SaintGimp/MotorController/README.md

# MotorController

The board files use the libraries and design rules from https://github.com/SaintGimp/Eagle.
