SaintGimp/MotorController/board/BOM.xlsx

Sheet: BOM
Qty | Value | Device | Package | Parts | Manufacturer Part Number | Description | Notes
1 | 1000uF | CAP-POL-25-14 | CAP-POL-25-14 | C11 | EEU-FR1H102 | Polarized Capacitor | Expensive but long-life, 470uF version is EEU-FR1H471B
2 | 10uF | CAPACITOR-5MM | CAPACITOR-5MM | C8, C9 | FK20X7S1H106K | Ceramic Capacitor | Ammo pack
3 | 1uF | CAPACITOR-2.5MM | CAPACITOR-2.5MM | C6, C7, C10 | FK14X7R1H105K | Ceramic Capacitor | Bulk (maybe)
3 | 0.1uF | CAPACITOR-2.5MM | CAPACITOR-2.5MM | C1, C2, C5 | K104K15X7RF53L2 | Ceramic Capacitor | Bulk
2 | 20pF | CAPACITOR-2.5MM | CAPACITOR-2.5MM | C3, C4 | SR151A200JAR | Ceramic Capacitor | Bulk
1 | 576K | RESISTOR-7.5MM | AXIAL-7.5MM | R7 | MFR-25FBF52-576K |  | Bulk
2 | 10K | RESISTOR-7.5MM | AXIAL-7.5MM | R2, R8 | MFR-25FBF52-10K |  | Bulk
2 | 1K | RESISTOR-7.5MM | AXIAL-7.5MM | R5, R6 | MFR-25FBF52-1K |  | Bulk
2 | 220 | RESISTOR-7.5MM | AXIAL-7.5MM | R3, R4 | MF1/4DC2200F |  | Bulk
1 | 68 | RESISTOR-7.5MM | AXIAL-7.5MM | R1 | MF1/4DC68R0F |  | Bulk
1 | 27V | ZENER-7.5 | ZDIO-7.5 | D2 | 1N5254B-TAP | Zener Diode | Ammo pack
1 | 22V | ZENER-7.5 | ZDIO-7.5 | D1 | 1N5251B-TAP | Zener Diode | Ammo pack
2 | 10V | ZENER-7.5 | ZDIO-7.5 | D3, D4 | 1N5240B-TAP | Zener Diode | Ammo pack
1 | BT139X-600E | TRIAC-H | TO220BH | Q1 | BT137-600E,127 | TRIAC
2 | SUP53P06-20-E3 | SUP53P06-20-E3 | TO220BH | Q2, Q3 | SUP53P06-20-E3 | P-Channel MOSFET
1 | OKI-78SR-5/1.5-W36H-C | DC-CONV | DC-CONV | DC1 | OKI-78SR-5/1.5-W36H-C | DC-DC Converter
1 | ATMEGA328P-PU | ATMEGA328P-PU | DIP28 | IC1 | ATMEGA328P-PU | 8-bit Microcontroller with In-System Programmable Flash
1 | 28P | Socket | DIP28 | IC1 | 1-2199298-9 |  | Optional
1 | 16Mhz | CRYSTAL-V | CRYSTAL-V | Y1 | ATS16A | Crystal Oscillator
1 | 4A-MEDIUM-BLOW | FUSE | FUSE_5X20MM | F1 | 5MT 4-R |  | Derated 25% per standard, consider fast-blow?
2 | 4A | FUSE CLIP | FUSE_CLIP_5MM | F1 | 01000056Z
4 | SWITCH-MOMENTARY-6MM | SWITCH-MOMENTARY-6MM | TACTILE-SWITCH-6MM | S1, S2, S3, S4 | B3F-1020
 | version 3.1.1

Sheet: Inventory
Qty | Description | Manufacturer Part Number | Substitutes | Totals | Unit Inventory | 2015-07-30 | 10 | 2015-10-27 | 20 | 2016-04-04 | 25 | 2016-09-12 | 25 | 2017-09-14 | 50 | Adjust | 2019-04-23 | 57 | 2021-09-21
2 | P-MOSFET | SUP53P06-20-E3 |  | 127 | 63.5 | 0 |  | 40 | -40 | 50 | -50 | 50 | -50 | 105 | -100 | 6 | 110 | -114 | 120
1 | 576K resistor | MFR-25FBF52-576K |  | 63 | 63 | 200 | -10 | * | -20 | * | -25 | * | -25 | * | -50 |  | * | -57 | 50
2 | 10V zener | 1N5240B-TAP |  | 139 | 69.5 | 100 | -20 | * | -40 | 100 | -50 | * | -50 | 100 | -100 | -7 | 100 | -114 | 120
1 | 1000uF capacitor | EEU-FR1H102 | 50YXJ1000M16X25 | 60 | 60 | 10 | -10 | 20 | -20 | 50 | -25 | * | -25 | 55 | -50 | 2 | 50 | -57 | 60
2 | 220R resistor | MF1/4DC2200F |  | 130 | 65 | 100 | -20 | * | -40 | 100 | -50 | * | -50 | 100 | -100 | -16 | 100 | -114 | 120
1 | 68R resistor | MF1/4DC68R0F |  | 113 | 113 | 100 | -10 | * | -20 | * | -25 | * | -25 | 100 | -50 |  | * | -57 | 100
1 | DIP socket | 1-2199298-9 |  | 64 | 64 | 10 | -10 | 20 | -20 | 25 | -25 | 25 | -25 | 55 | -50 | 1 | 55 | -57 | 60
1 | MCU | ATMEGA328P-PU |  | 68 | 68 | 10 | -10 | 20 | -20 | 25 | -25 | 25 | -25 | 55 | -50 | -5 | 65 | -57 | 60
1 | Crystal | ATS16A |  | 63 | 63 | 10 | -10 | 20 | -20 | 25 | -25 | 25 | -25 | 55 | -50 |  | 55 | -57 | 60
3 | 1uF capacitor | FK14X7R1H105K |  | 191 | 63.66666667 | 100 | -30 | * | -60 | 100 | -75 | 100 | -75 | 120 | -150 | 12 | 140 | -171 | 180
3 | 0.1uF capacitor | K104K15X7RF53L2 |  | 185 | 61.66666667 | 100 | -30 | * | -60 | 100 | -75 | 100 | -75 | 100 | -150 | 16 | 150 | -171 | 180
2 | 20pF capacitor | SR151A200JAR | SL151A200JAB | 134 | 67 | 100 | -20 | * | -40 | 100 | -50 | * | -50 | 100 | -100 | 8 | 100 | -114 | 100
2 | Fuse clip | 01000056Z |  | 120 | 60 | 20 | -20 | 40 | -40 | 50 | -50 | 50 | -50 | 105 | -100 | 9 | 100 | -114 | 120
1 | 4A fuse | 0234004.MXP |  | 67 | 67 | 10 | -10 | 20 | -20 | 25 | -25 | 25 | -25 | 55 | -50 | 4 | 50 | -57 | 65
1 | DC converter | OKI-78SR-5/1.5-W36H-C | 7805SRH-C | 60 | 60 | 10 | -10 | 20 | -20 | 25 | -25 | 25 | -25 | 55 | -50 | 2 | 50 | -57 | 60
2 | 1K resistor | MFR-25FBF52-1K |  | 130 | 65 | 200 | -20 | * | -40 | * | -50 | * | -50 | 70 | -100 | 14 | 100 | -114 | 120
2 | 10K resistor | MFR-25FBF52-10K | MF0207FTE52-10K | 136 | 68 | 200 | -20 | * | -40 | * | -50 | * | -50 | 70 | -100 |  | 120 | -114 | 120
1 | Triac | BT137-600E,127 |  | 100 | 100 | 10 | -10 | 20 | -20 | 25 | -25 | 25 | -25 | 55 | -50 | 2 | 50 | -57 | 100
1 | 22V zener | 1N5251B-TAP |  | 153 | 153 | 100 | -10 | * | -20 | * | -25 | * | -25 | 40 | -50 |  | 100 | -57 | 100
1 | 27V zener | 1N5254B-TAP |  | 143 | 143 | 100 | -10 | * | -20 | * | -25 | * | -25 | 40 | -50 | -10 | 100 | -57 | 100
2 | 10uF capacitor | FK20X7S1H106K |  | 126 | 63 | 100 | -20 | * | -40 | 100 | -50 | * | -50 | 100 | -100 |  | 100 | -114 | 100
1 | PCB | PCB 3.1.1 |  | 76 | 76 |  | -10 |  | -20 |  | -25 |  | -25 |  | -50 | 188 |  | -57 | 75
 |  |  |  |  | 60
