SaintGimp/MotorController/board/MotorController.brd

## EAGLE design board/MotorController.brd (2019-05-02)

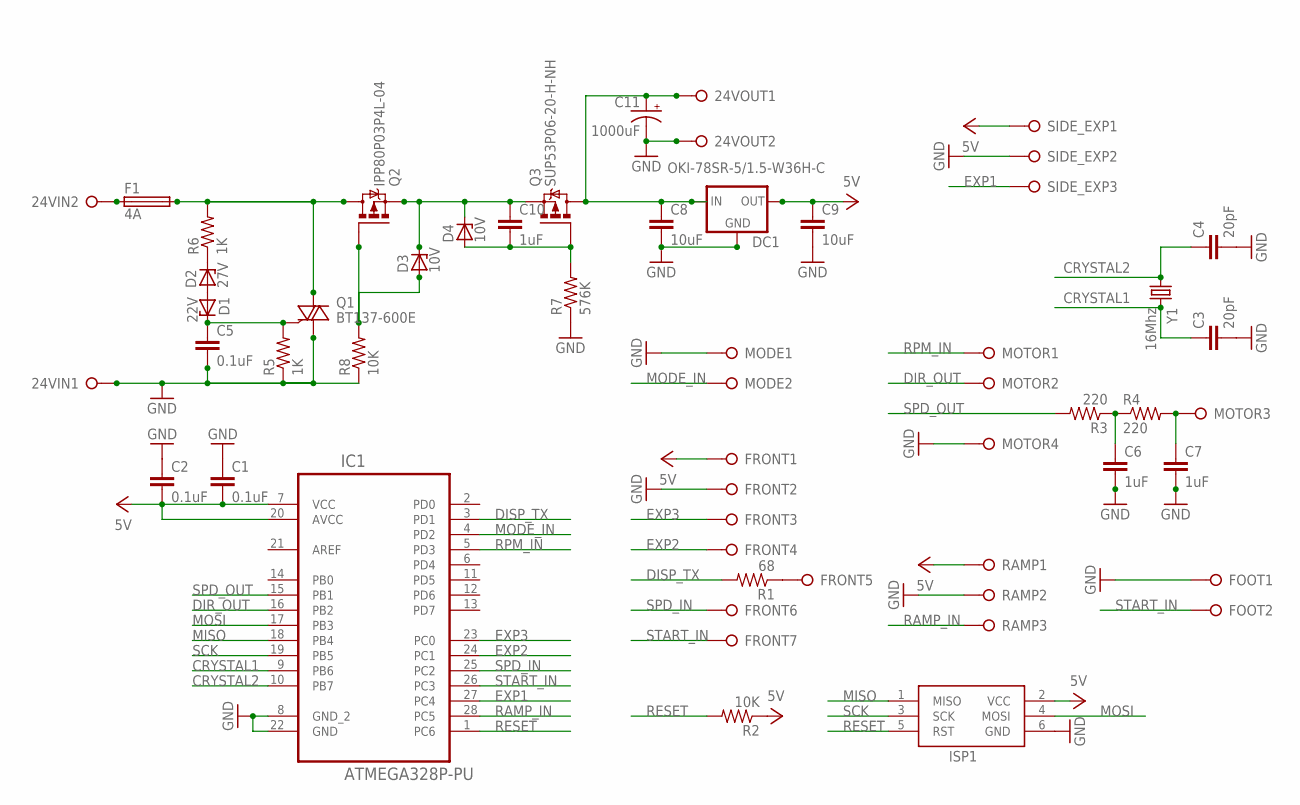
[picture p1: schematic MotorController.sch]

Parts:
24VIN, 24VOUT: PINHD-1X2BIG; 1X02-BIG
C1, C2, C5: 0.1uF; CAPACITOR-2.5MM
C3, C4: 20pF; CAPACITOR-2.5MM
C6, C7, C10: 1uF; CAPACITOR-2.5MM
C8, C9: 10uF; CAPACITOR-5MM
C11: 1000uF; CAP-POL-25-14
D1: 22V; ZDIO-7.5
D2: 27V; ZDIO-7.5
D3, D4: 10V; ZDIO-7.5
DC1: OKI-78SR-5/1.5-W36H-C; DC-CONV
F1: 4A; FUSE_HOLDER_5X20MM
FOOT: PINHD-1X2BIG; 1X02-BIG
FRONT: PINHD-1X7BIG; 1X07-BIG
IC1: ATMEGA328P-PU; DIP28
ISP1: ICSP-HEADER-6; ICSP-HEADER
MODE: PINHD-1X2BIG; 1X02-BIG
MOTOR: PINHD-1X4BIG; 1X04-BIG
Q1: BT137-600E; TO220BH-NO-HOLE
Q2: IPP80P03P4L-04; TO220BH-NO-HOLE
Q3: SUP53P06-20-H-NH; TO220BH-NO-HOLE
R1: 68; AXIAL-7.5MM
R2, R8: 10K; AXIAL-7.5MM
R3, R4: 220; AXIAL-7.5MM
R5, R6: 1K; AXIAL-7.5MM
R7: 576K; AXIAL-7.5MM
RAMP: PINHD-1X3BIG; 1X03-BIG
SIDE_EXP: PINHD-1X3BIG; 1X03-BIG
Y1: 16Mhz; CRYSTAL-V

Connections:
24V: F1.2, Q1.P2 (A2), Q2.P2 (D), R6.P$2 (2)
24V-PROTECTED: 24VOUT.1, C8.1, C11.+, DC1.P1 (IN), Q3.P2 (D)
CRYSTAL1: C3.1, IC1.9 (PB6), Y1.2
CRYSTAL2: C4.1, IC1.10 (PB7), Y1.1
DIR_OUT: IC1.16 (PB2), MOTOR.2
DISP_TX: IC1.3 (PD1), R1.P$2 (2)
EXP1: IC1.27 (PC4), SIDE_EXP.3
EXP2: FRONT.4, IC1.24 (PC1)
EXP3: FRONT.3, IC1.23 (PC0)
GND: 24VIN.1, 24VOUT.2, C1.1, C2.1, C3.2, C4.2, C5.2, C6.2, C7.2, C8.2, C9.2, C11.-, DC1.P2 (GND), FOOT.1, FRONT.2, IC1.8 (GND_2), IC1.22 (GND), ISP1.6 (GND), MODE.1, MOTOR.4, Q1.P1 (A1), R5.P$1 (1), R7.P$1 (1), R8.P$1 (1), RAMP.2, SIDE_EXP.2
MISO: IC1.18 (PB4), ISP1.1 (MISO)
MODE_IN: IC1.4 (PD2), MODE.2
MOSI: IC1.17 (PB3), ISP1.4 (MOSI)
unnamed: C6.1, R3.P$1 (1), R4.P$1 (1)
unnamed: 24VIN.2, F1.1
unnamed: D3.A, Q2.P1 (G), R8.P$2 (2)
unnamed: D2.C, R6.P$1 (1)
unnamed: D1.A, D2.A
unnamed: C5.1, D1.C, Q1.P3 (G), R5.P$2 (2)
unnamed: FRONT.5, R1.P$1 (1)
unnamed: C10.1, D3.C, D4.C, Q2.P3 (S), Q3.P3 (S)
unnamed: C7.1, MOTOR.3, R4.P$2 (2)
unnamed: C10.2, D4.A, Q3.P1 (G), R7.P$2 (2)
RAMP_IN: IC1.28 (PC5), RAMP.3
RESET: IC1.1 (PC6), ISP1.5 (RST), R2.P$2 (2)
RPM_IN: IC1.5 (PD3), MOTOR.1
SCK: IC1.19 (PB5), ISP1.3 (SCK)
SPD_IN: FRONT.6, IC1.25 (PC2)
SPD_OUT: IC1.15 (PB1), R3.P$2 (2)
START_IN: FOOT.2, FRONT.7, IC1.26 (PC3)
VCC: C1.2, C2.2, C9.1, DC1.P3 (OUT), FRONT.1, IC1.7 (VCC), IC1.20 (AVCC), ISP1.2 (VCC), R2.P$1 (1), RAMP.1, SIDE_EXP.1

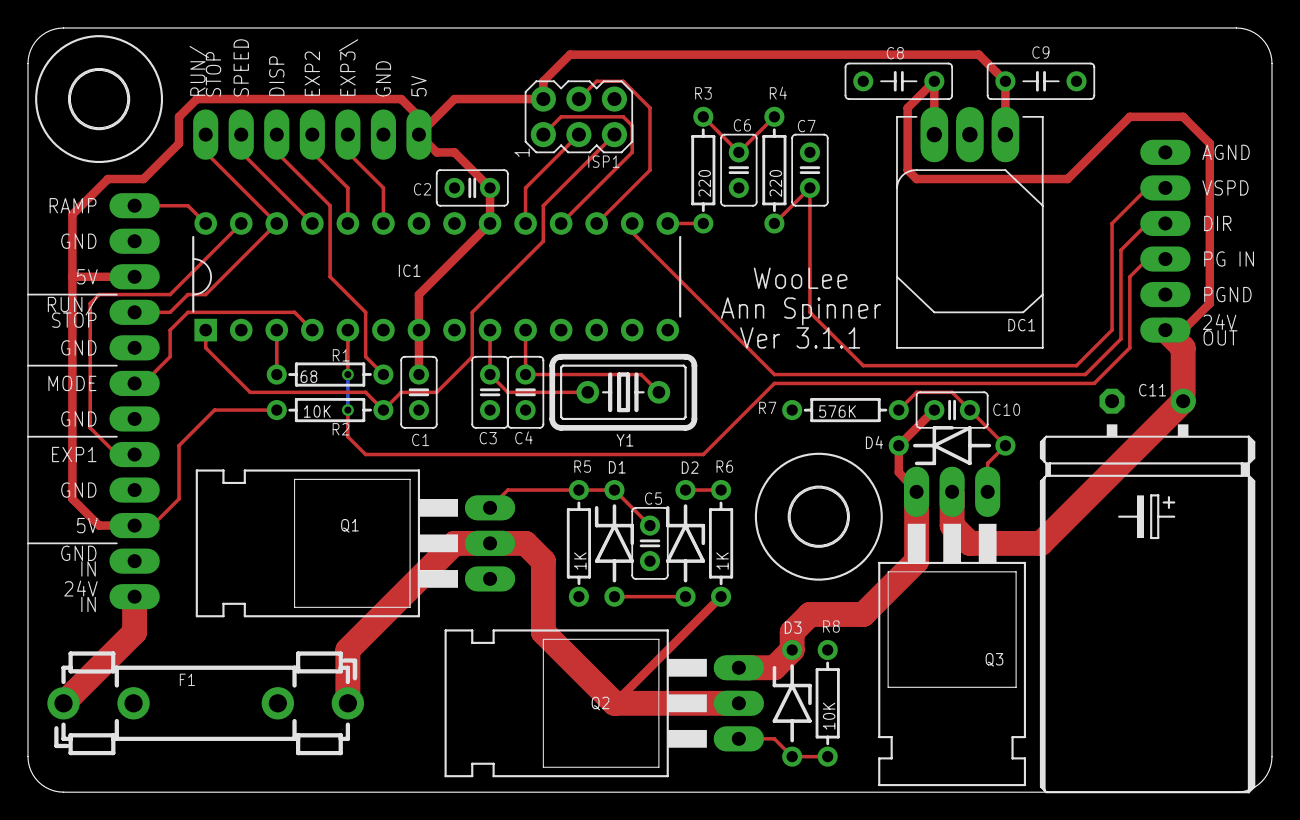
[picture p2: board MotorController.brd from above]

Board: 2 copper layers, 88.9 x 54.6 mm, 41 parts (0 on the bottom side), 31 nets.

Other parts of the board:
U$2, U$4: 4,1
