SaintGimp/MotorController/board/FrontPanel.brd

## EAGLE design board/FrontPanel.brd (2016-07-06)

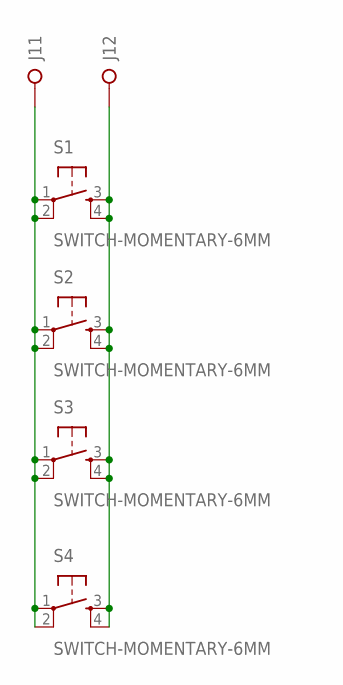
[picture p3: schematic FrontPanel.sch]

Parts:
J1: PINHD-1X2BIG; 1X02-BIG
S1, S2, S3, S4: SWITCH-MOMENTARY-6MM; TACTILE-SWITCH-6MM

Connections:
unnamed: J1.1, S1.1, S1.2, S2.1, S2.2, S3.1, S3.2, S4.1, S4.2
unnamed: J1.2, S1.3, S1.4, S2.3, S2.4, S3.3, S3.4, S4.3, S4.4

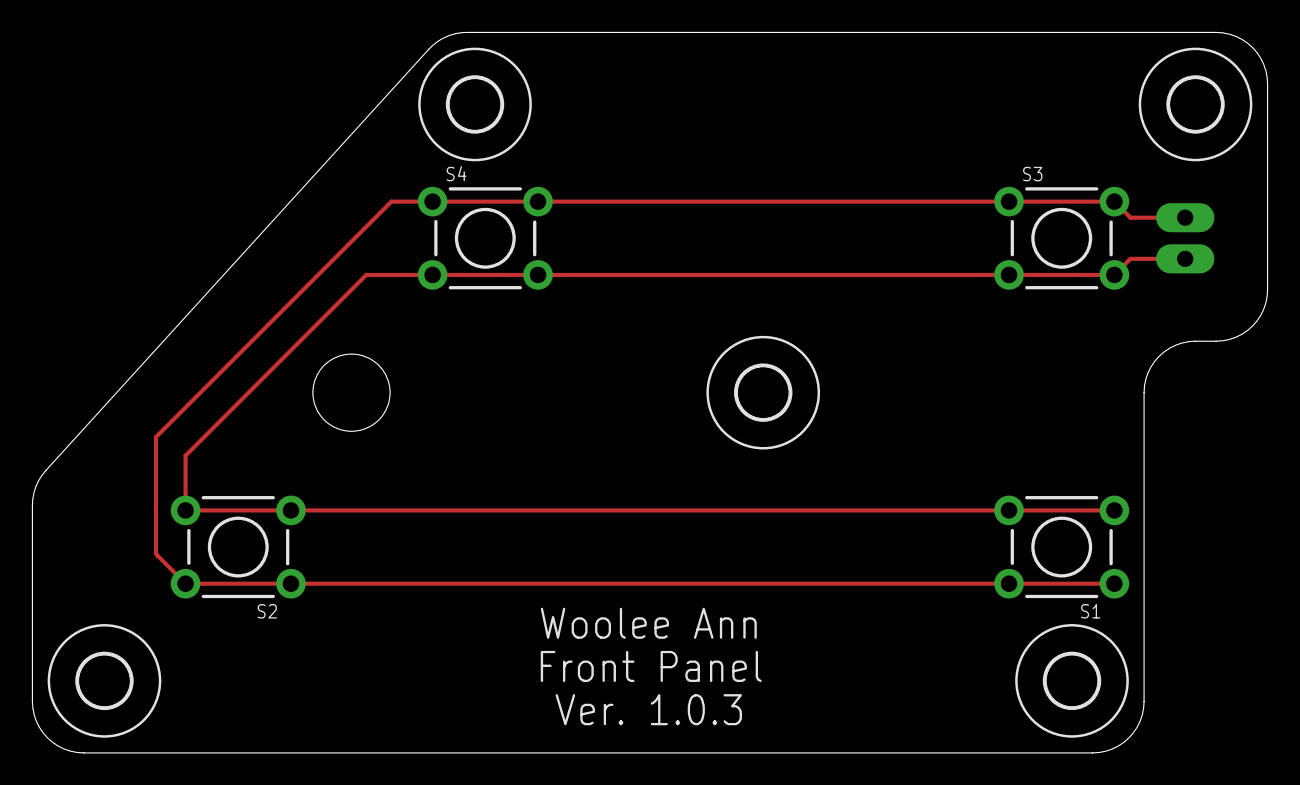
[picture p4: board FrontPanel.brd from above]

Board: 2 copper layers, 76.2 x 44.5 mm, 10 parts (0 on the bottom side), 2 nets.

Other parts of the board:
U$1, U$2, U$3, U$4, U$5: 3,2
