SaintGimp/MotorController/(commit log)

2013-12-05 Added rate pot, on/off and direction switches
2013-12-07 Arduino-tiny core for ATTiny MCUs
2013-12-07 Assume that ATTiny85 is going to need RESET disabled
    [ArduinoPrototype.ino]
2013-12-10 Fixed PWM output and renamed sketch
    [MotorController.ino]
2013-12-14 Include Eagle design files and move stuff around
    [MotorController.brd, MotorController.sch]
2013-12-14 Add a ground pour on the bottom plane and route all power and signal traces on the top
    [MotorController.brd, MotorController.sch]
2013-12-14 Tweaked schematic
    [MotorController.brd, MotorController.sch]
2013-12-14 Switch to a top GND pour
    [MotorController.brd, MotorController.sch]
2013-12-14 Switch to a horizontal regulator and change board layout to fit
    [MotorController.brd, MotorController.sch]
2013-12-28 Board tweaks, prototype labels
    [MotorController.brd]
2013-12-28 Only allow power on if current speed is 0
2014-01-02 Parameter tweaks based on prototype trials
2014-04-13 V2 prototype
    [PowerPrototype.brd, PowerPrototype.sch, ProcessorPrototype.brd, ProcessorPrototype.sch]
2014-04-17 Initial pass at a PCB and added clock code
    [MotorController.brd, MotorController.sch, PowerPrototype.brd, PowerPrototype.sch]
2014-04-28 PCB improvements
    [MotorController.brd, MotorController.sch]
2015-04-08 Update with current design rules and current library
    [MotorController.brd, MotorController.sch]
2015-04-08 Pull up reset line
    [MotorController.brd, MotorController.sch]
2015-04-09 Replace I2C with serial library
    [MotorController.ino]
2015-05-26 New board layout
    [MotorController.brd, MotorController.sch]
2015-05-26 Restore resistor values
    [MotorController.brd, MotorController.sch]
2015-05-26 Add dimensions
    [MotorController.brd]
2015-05-28 Board tweaks
    [MotorController.brd, MotorController.sch]
2015-05-28 Board layout improvements
    [MotorController.brd, MotorController.sch]
2015-05-28 Fix position of D3 label
    [MotorController.brd]
2015-05-29 Remove old prototype files
    [PowerPrototype.brd, PowerPrototype.sch, ProcessorPrototype.brd, ProcessorPrototype.sch]
2015-06-06 Change triac value
    [BOM.xlsx, MotorController.brd, MotorController.sch]
2015-06-06 Updated BOM
    [BOM.xlsx]
2015-07-10 Fix power input labels and increase isolation for ground plane
    [MotorController.brd]
2015-07-10 More BOM updates
    [BOM.xlsx]
2015-07-13 Start front panel board
    [FrontPanel.sch]
2015-07-13 Switch to pin headers and ATMega328P
    [MotorController.brd, MotorController.sch]
2015-07-18 Version 3, many changes
    [BOM.xlsx, MotorController.brd, MotorController.sch]
2015-07-18 Add soft-start capability to avoid high inrush current
    [BOM.xlsx, MotorController.brd, MotorController.sch]
2015-07-25 Front panel design with dimension markings
    [FrontPanel.brd, FrontPanel.sch]
2015-07-25 Many changes for version 3
    [BOM.xlsx, MotorController.brd, MotorController.sch]
2015-07-25 Clean up front panel
    [FrontPanel.brd]
2015-07-25 Front panel tweaks
    [FrontPanel.brd]
2015-07-27 Miter corners of control board
    [MotorController.brd]
2015-07-27 Adjust front panel layout
    [FrontPanel.brd]
2015-07-27 Spread out front panel buttons, flip terminal silkscreen to back
    [FrontPanel.brd]
2015-07-29 Improve bypass cap layout
    [MotorController.brd]
2015-07-29 Adjust spacing of DAC filter and ICSP header
    [MotorController.brd]
2015-07-29 Adjust clearance of MCU power trace
    [MotorController.brd]
2015-07-29 Revert MCU power trace
    [MotorController.brd]
2015-07-29 Tweak label
    [MotorController.brd]
2015-08-08 Tweak TO220 packages and add board heatsink
    [BOM.xlsx, MotorController.brd, MotorController.sch]
2015-08-08 Fix the label order of caps
    [BOM.xlsx, MotorController.brd, MotorController.sch]
2015-08-08 More adjustments to BOM and parts labels
    [BOM.xlsx]
2015-08-15 Even more BOM and label adjustments
    [BOM.xlsx]
2015-08-16 Revert back to previous triac circuit
    [MotorController.brd, MotorController.sch]
2015-08-16 Connect RPM IN to pin 5 which supports interrupts
    [MotorController.brd, MotorController.sch]
2015-08-16 Bump board version
    [MotorController.brd]
2015-08-28 Tweak mask settings in design rules
    [MotorController.brd]
2015-08-28 Bump patch version
    [MotorController.brd]
2015-10-27 Update DRU for front panel and bump version
    [FrontPanel.brd]
2015-10-27 Update library and DRU for main board
    [MotorController.brd, MotorController.sch]
2015-10-28 Switched to 60V MOSFETs and updated BOM and inventory
    [BOM.xlsx, MotorController.brd, MotorController.sch]
2016-07-06 Add the ability to reset the clock by shorting EXP3 and toggle debug display by shorting EXP2
    [MotorController.ino]
2016-07-06 Add hole to front panel
    [FrontPanel.brd]
2016-07-06 Update inventory
    [BOM.xlsx]
2016-08-11 Switch to the Bounce2 library
2016-08-11 Remove delay from main loop and control motor updates with a specific delay
2016-08-11 Convert periodic tasks to use ArduinoThread library
2016-08-14 Add libraries as direct project files so we always have the correct versions
    [MotorController.ino]
2016-08-15 Shrink the loop time by not multisampling the ramp pot, which doesn't need it
    [MotorController.ino]
2016-09-12 Updated inventory
    [BOM.xlsx]
2016-10-06 Fix an off-by-one bug in the way we load clock values
    [MotorController.ino]
2017-09-15 Update stock
    [BOM.xlsx]
2019-05-02 Fix a missing line in board outline and generate JCLPCB gerbers
    [MotorController.brd]
2019-05-02 Updated stock levels
    [BOM.xlsx]
2022-05-07 Update BOM and test procedures
    [BOM.xlsx]
2022-09-20 Fix overflow bug in hours display
    [MotorController.ino]
2023-08-21 Changes to support RioRand motor driver module
